jerrytianq/Raidillon/Raidillon.pdf

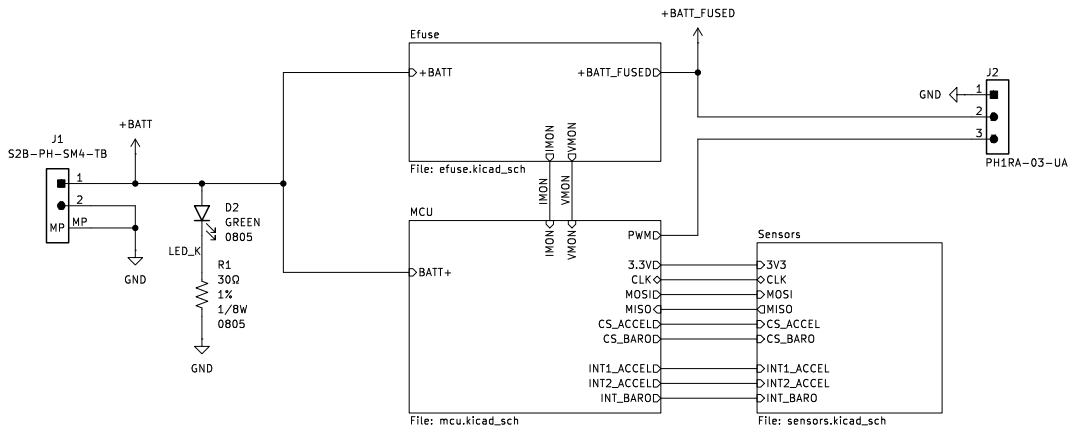
[picture p1: page 1]

Efuse File: efuse.kicad_sch +BATT

INT1_ACCEL Sensors File: sensors.kicad_sch VMON

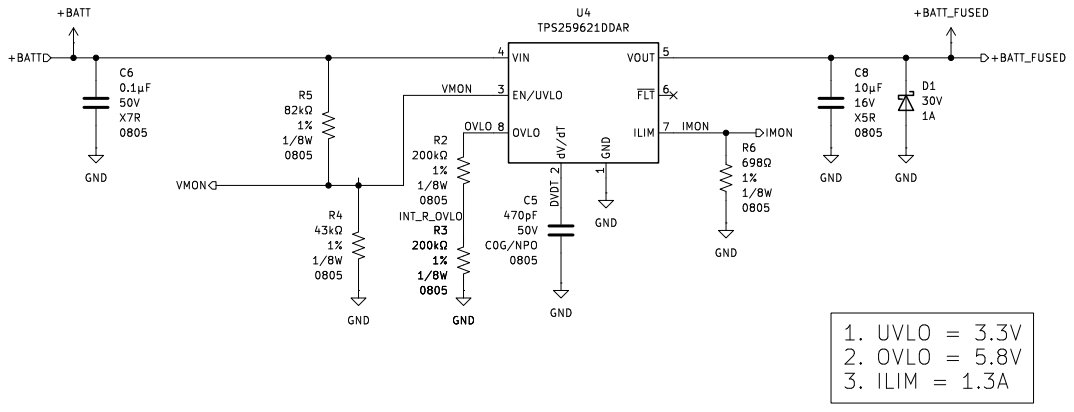
[picture p2: page 2]

2 EN/UVLO 3 VIN 4 VOUT 5 ~{FLT}6

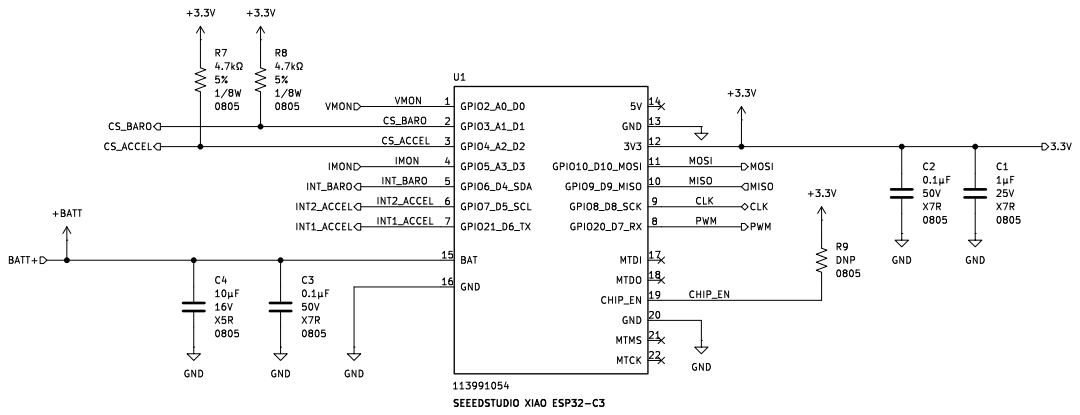
[picture p3: page 3]

File: mcu.kicad_sch Sheet: /MCU/
Id: 3/4 Title: Radillon

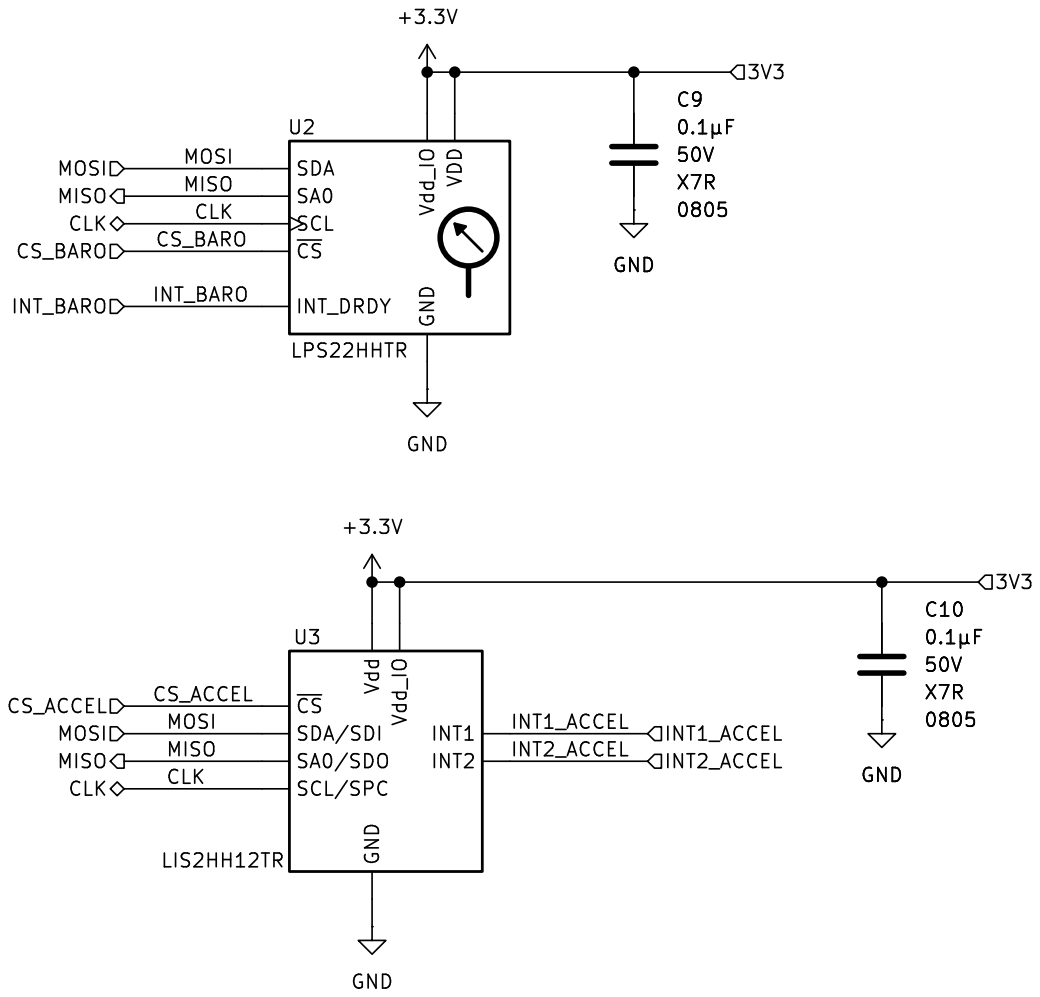
[picture p4: page 4]

CLK CLK MOSI MISO

3V3 MOSI
SDA/SDI GND Vdd U3

File: sensors.kicad_sch Sheet: /Sensors/
Id: 4/4 Title: Radillon
