jerrytianq/Raidillon/Raidillon.kicad_pcb

## KiCad design Raidillon.kicad_pcb (2025-01-30)

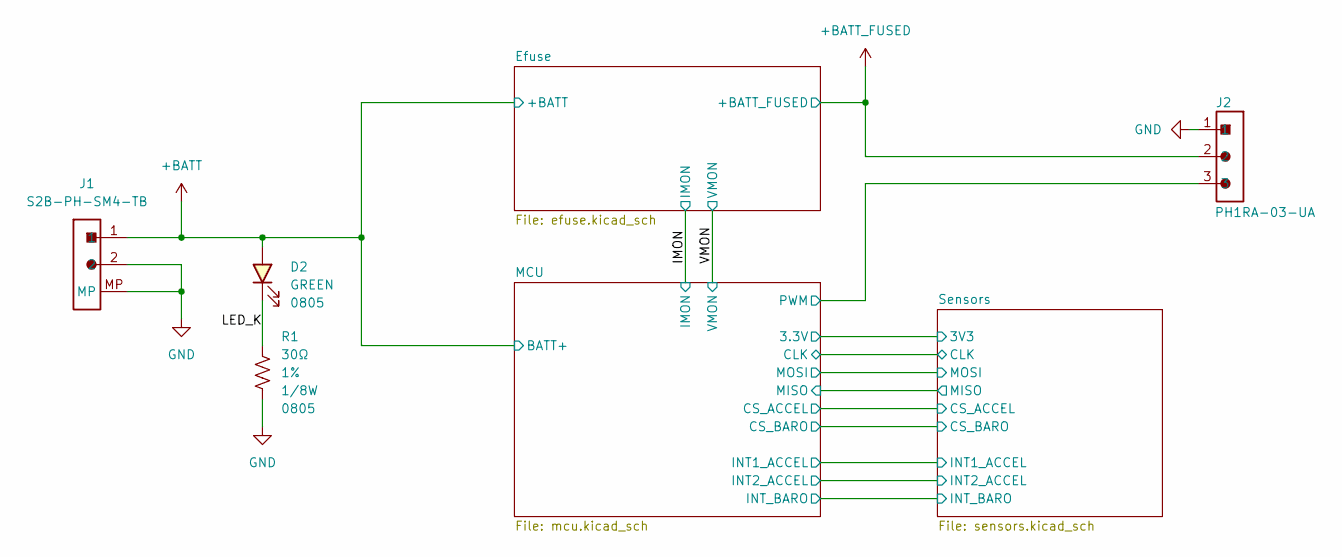
[picture p5: schematic Raidillon.kicad_sch, Radillon]

Parts:
D2: 150080GS75000; LED_0805_2012Metric_Pad1.15x1.40mm_HandSolder
J1: S2B-PH-SM4-TB; JST_PH_S2B-PH-SM4-TB_1x02-1MP_P2.00mm_Horizontal
J2: PH1RA-03-UA; PinHeader_1x03_P2.54mm_Horizontal
R1: RC0805FR-0730RL; R_0805_2012Metric_Pad1.20x1.40mm_HandSolder; Tolerance 1%

Connections:
+BATT: D2.2 (A), J1.1; also elsewhere on the board
+BATT_FUSED: J2.2; also elsewhere on the board
/LED_K: D2.1 (K), R1.1
/MCU/PWM: J2.3; also elsewhere on the board
GND: J1.2, J1.MP, J2.1, R1.2; also elsewhere on the board

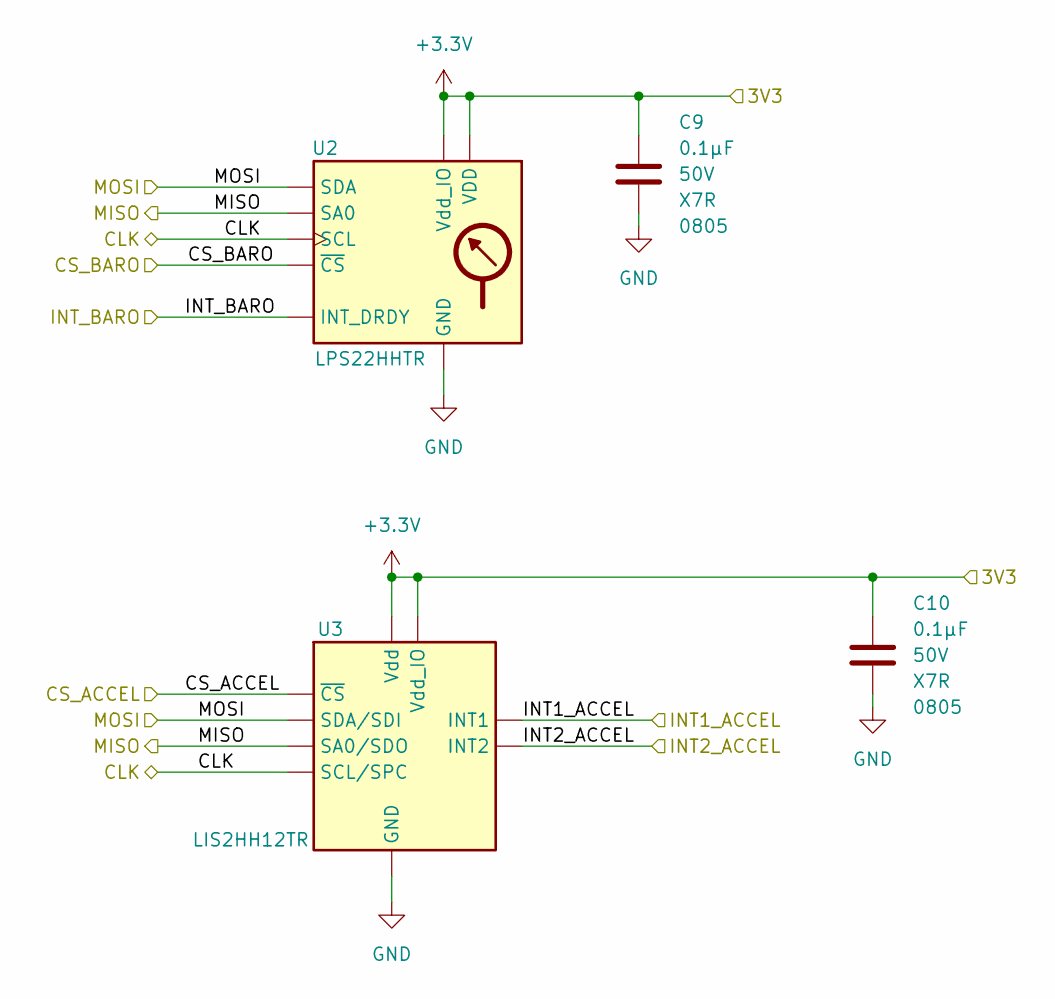
[picture p6: schematic sensors.kicad_sch, Radillon]

Parts:
C9, C10: CL21B104KBCNNNC; C_0805_2012Metric_Pad1.18x1.45mm_HandSolder; Rated Voltage 50V
U2: LPS22HHTR; ST_HLGA-10_LPS22HHTR
U3: LIS2HH12TR; LGA-12_LIS2HH12TR

Connections:
+3.3V: C9.1, C10.1, U2.1 (Vdd_IO), U2.10 (VDD), U3.9 (Vdd), U3.10 (Vdd_IO); also elsewhere on the board
/MCU/CLK: U2.2 (SCL), U3.1 (SCL/SPC); also elsewhere on the board
/MCU/CS_ACCEL: U3.2 (~CS); also elsewhere on the board
/MCU/CS_BARO: U2.6 (~CS); also elsewhere on the board
/MCU/INT1_ACCEL: U3.12 (INT1); also elsewhere on the board
/MCU/INT2_ACCEL: U3.11 (INT2); also elsewhere on the board
/MCU/INT_BARO: U2.7 (INT_DRDY); also elsewhere on the board
/MCU/MISO: U2.5 (SA0), U3.3 (SA0/SDO); also elsewhere on the board
/MCU/MOSI: U2.4 (SDA), U3.4 (SDA/SDI); also elsewhere on the board
GND: C9.2, C10.2, U2.3 (GND), U2.8 (GND), U2.9 (GND), U3.5 (RES), U3.6 (GND), U3.7 (GND), U3.8 (GND); also elsewhere on the board

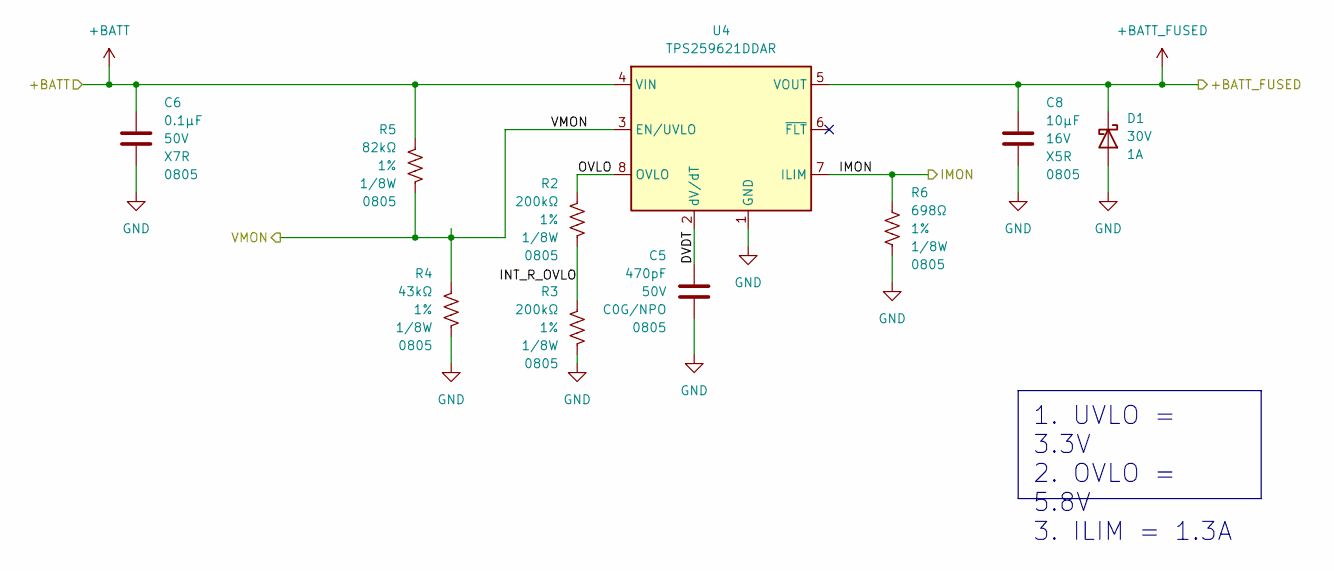
[picture p7: schematic efuse.kicad_sch, Radillon]

Parts:
C5: CC0805JRNPO9BN471; C_0805_2012Metric_Pad1.18x1.45mm_HandSolder; Rated Voltage 50V
C6: CL21B104KBCNNNC; C_0805_2012Metric_Pad1.18x1.45mm_HandSolder; Rated Voltage 50V
C8: GRM21BR61C106KE15K; C_0805_2012Metric_Pad1.18x1.45mm_HandSolder; Rated Voltage 16V
D1: MSS1P3L-M3/89A; D_MicroSMP_AK_MSS1P3L-M3_89A; Voltage - DC Reverse (V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 30V
R2, R3: RC0805FR-07200KL; R_0805_2012Metric_Pad1.20x1.40mm_HandSolder; Tolerance 1%
R4: RC0805FR-0743KL; R_0805_2012Metric_Pad1.20x1.40mm_HandSolder; Tolerance 1%
R5: RC0805FR-0782KL; R_0805_2012Metric_Pad1.20x1.40mm_HandSolder; Tolerance 1%
R6: RC0805FR-07698RL; R_0805_2012Metric_Pad1.20x1.40mm_HandSolder; Tolerance 1%
U4: TPS259621DDAR; SOIC-8-TPS259631DDAR; Voltage - Input 2.7V ~ 19V

Connections:
+BATT: C6.1, R5.1, U4.4 (VIN); also elsewhere on the board
+BATT_FUSED: C8.1, D1.1 (K), U4.5 (VOUT); also elsewhere on the board
/Efuse/DVDT: C5.1, U4.2 (dV/dT)
/Efuse/INT_R_OVLO: R2.2, R3.1
/Efuse/OVLO: R2.1, U4.8 (OVLO)
/IMON: R6.1, U4.7 (ILIM); also elsewhere on the board
/VMON: R4.1, R5.2, U4.3 (EN/UVLO); also elsewhere on the board
GND: C5.2, C6.2, C8.2, D1.2 (A), R3.2, R4.2, R6.2, U4.1 (GND), U4.9 (GND); also elsewhere on the board

Notes on the sheet:
1. UVLO = 3.3V 2. OVLO = 5.8V 3. ILIM = 1.3A

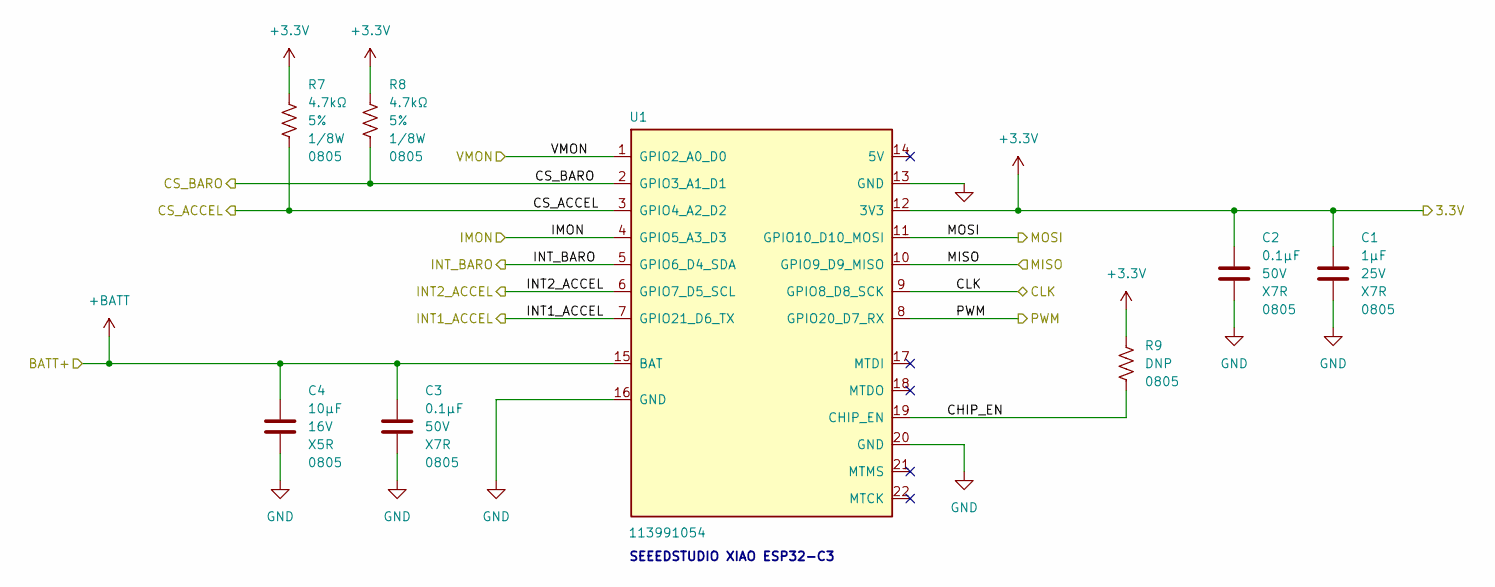
[picture p8: schematic mcu.kicad_sch, Radillon]

Parts:
C1: CL21B105KAFNNNE; C_0805_2012Metric_Pad1.18x1.45mm_HandSolder; Rated Voltage 25V
C2, C3: CL21B104KBCNNNC; C_0805_2012Metric_Pad1.18x1.45mm_HandSolder; Rated Voltage 50V
C4: GRM21BR61C106KE15K; C_0805_2012Metric_Pad1.18x1.45mm_HandSolder; Rated Voltage 16V
R7, R8: RMCF0805JT4K70; R_0805_2012Metric_Pad1.20x1.40mm_HandSolder; Tolerance 5%; PARTREV V.12
R9: DNP 0805; R_0805_2012Metric_Pad1.20x1.40mm_HandSolder; PARTREV V.12
U1: 113991054; XIAO-ESP32C3-SMD

Connections:
+3.3V: C1.1, C2.1, R7.1, R8.1, R9.1, U1.12 (3V3); also elsewhere on the board
+BATT: C3.1, C4.1, U1.15 (BAT); also elsewhere on the board
/IMON: U1.4 (GPIO5_A3_D3); also elsewhere on the board
/MCU/CHIP_EN: R9.2, U1.19 (CHIP_EN)
/MCU/CLK: U1.9 (GPIO8_D8_SCK); also elsewhere on the board
/MCU/CS_ACCEL: R7.2, U1.3 (GPIO4_A2_D2); also elsewhere on the board
/MCU/CS_BARO: R8.2, U1.2 (GPIO3_A1_D1); also elsewhere on the board
/MCU/INT1_ACCEL: U1.7 (GPIO21_D6_TX); also elsewhere on the board
/MCU/INT2_ACCEL: U1.6 (GPIO7_D5_SCL); also elsewhere on the board
/MCU/INT_BARO: U1.5 (GPIO6_D4_SDA); also elsewhere on the board
/MCU/MISO: U1.10 (GPIO9_D9_MISO); also elsewhere on the board
/MCU/MOSI: U1.11 (GPIO10_D10_MOSI); also elsewhere on the board
/MCU/PWM: U1.8 (GPIO20_D7_RX); also elsewhere on the board
/VMON: U1.1 (GPIO2_A0_D0); also elsewhere on the board
GND: C1.2, C2.2, C3.2, C4.2, U1.13 (GND), U1.16 (GND), U1.20 (GND); also elsewhere on the board

Notes on the sheet:
SEEEDSTUDIO XIAO ESP32-C3

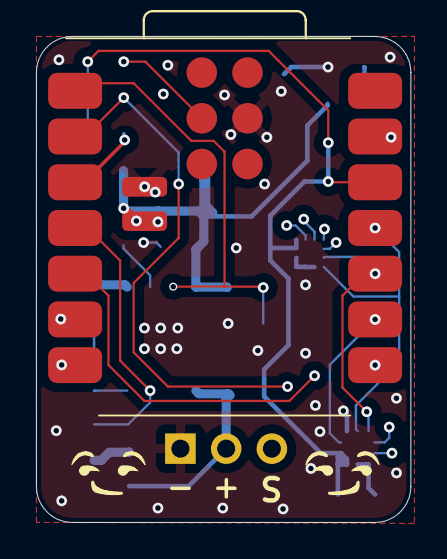
[picture p9: board Raidillon.kicad_pcb from above]

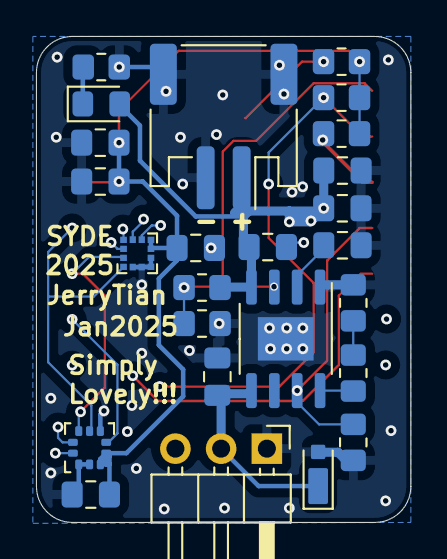
[picture p10: board Raidillon.kicad_pcb from below]

Board: 4 copper layers, 20.8 x 27.0 mm, 26 parts (25 on the bottom side), 20 nets.
