jerrytianq/Raidillon/(commit log)

2025-01-29 Removed duplicate pullup on chip enable resistor
    [Raidillon.kicad_pcb, Raidillon.kicad_sch, mcu.kicad_sch]
2025-01-30 ordered pcb
    [BOM-Raidillon.csv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]
2025-03-12 wrote basic uart code to trigger drop mechanism
